montoyamoraga/cuadra/hardware/chufe-v-0-rev-a/chufe-v-0-rev-a.kicad_sch

## KiCad design hardware/chufe-v-0-rev-a/chufe-v-0-rev-a.kicad_sch (2026-10-26)

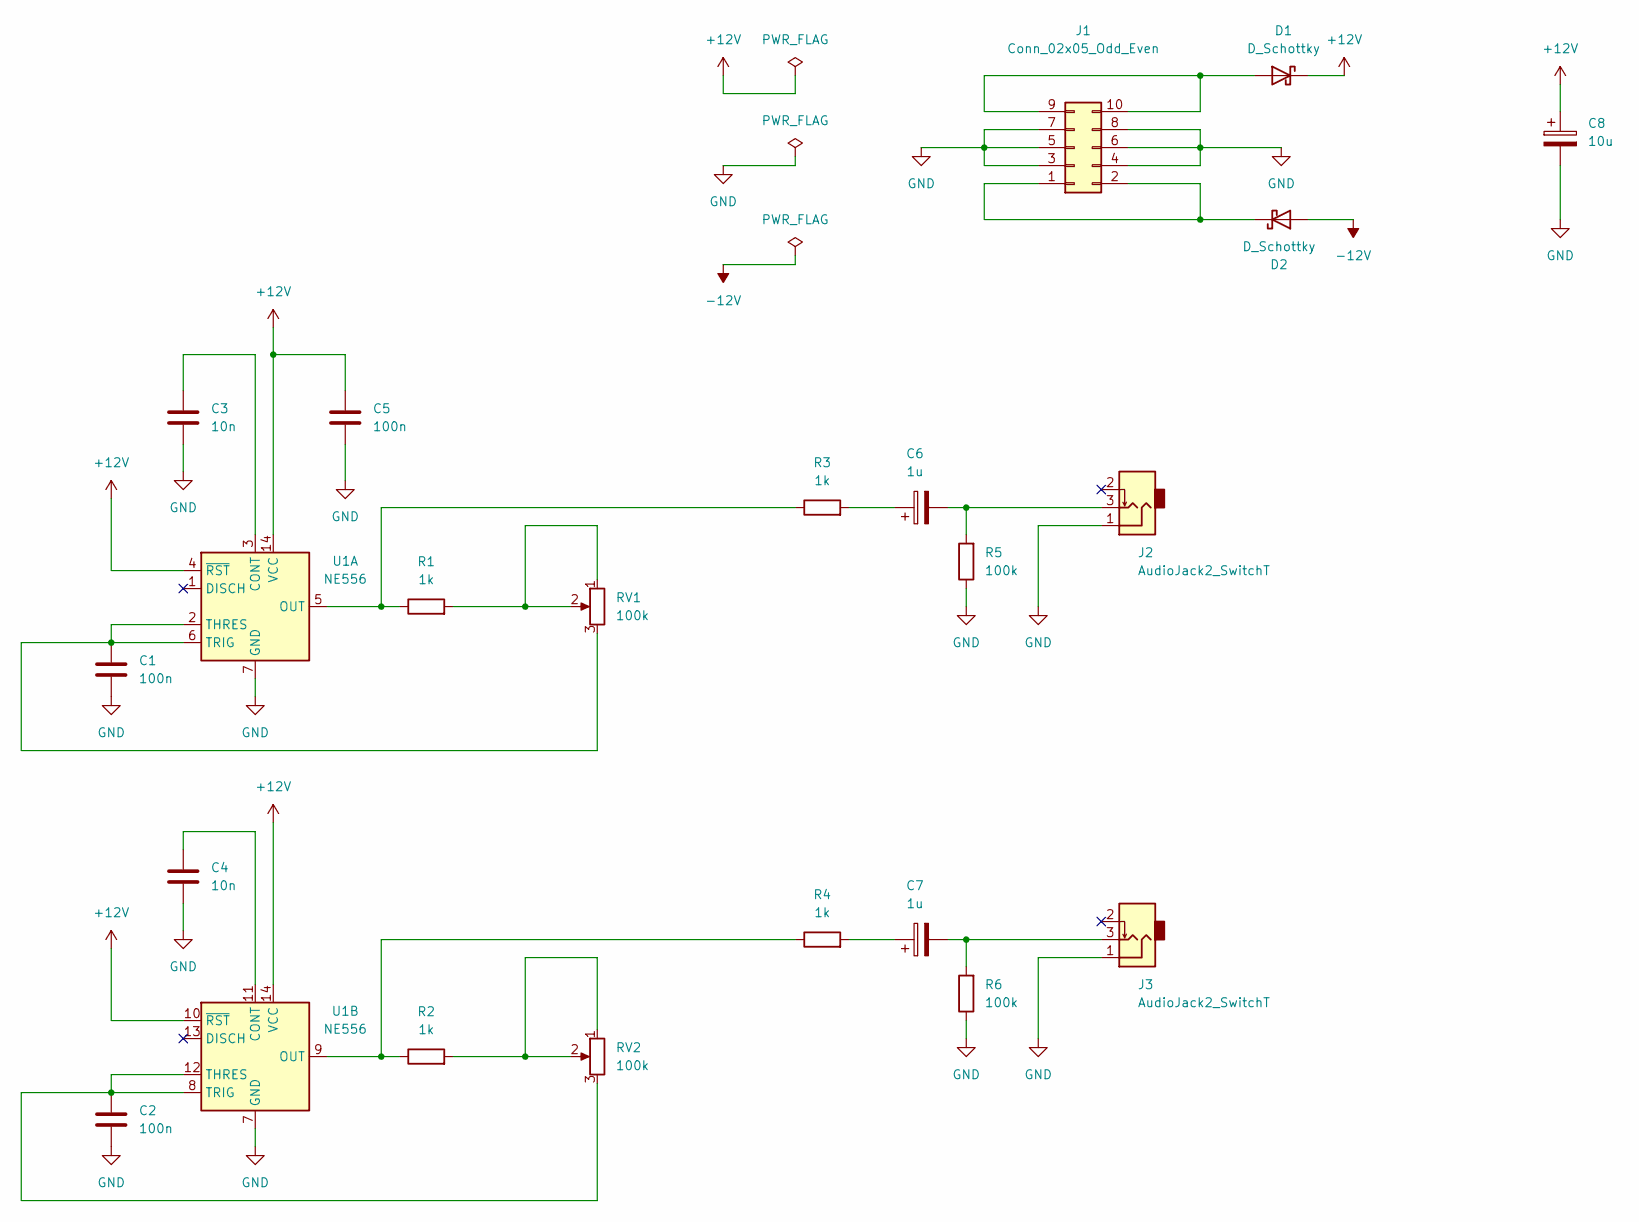
[picture p1: schematic chufe-v-0-rev-a.kicad_sch]

Parts:
C1, C2, C5: 100n
C3, C4: 10n
C6, C7: 1u
C8: 10u
D1, D2: D_Schottky
J1: Conn_02x05_Odd_Even
J2, J3: AudioJack2_SwitchT
R1, R2, R3, R4: 1k
R5, R6: 100k
RV1, RV2: 100k
U1: NE556

Connections:
+12V: C5.1, C8.1, D1.1 (K), U1.4 (~RST), U1.10 (~RST), U1.14 (VCC)
-12V: D2.2 (A)
GND: C1.2, C2.2, C3.2, C4.2, C5.2, C8.2, J1.3, J1.4, J1.5, J1.6, J1.7, J1.8, J2.1, J3.1, R5.1, R6.1, U1.7 (GND)
unnamed: C1.1, RV1.3, U1.2 (THRES), U1.6 (TRIG)
unnamed: C2.1, RV2.3, U1.8 (TRIG), U1.12 (THRES)
unnamed: C3.1, U1.3 (CONT)
unnamed: C4.1, U1.11 (CONT)
unnamed: C6.1, R3.2
unnamed: C6.2, J2.3, R5.2
unnamed: C7.1, R4.2
unnamed: C7.2, J3.3, R6.2
unnamed: D1.2 (A), J1.9, J1.10
unnamed: D2.1 (K), J1.1, J1.2
unnamed: R1.1, R3.1, U1.5 (OUT)
unnamed: R1.2, RV1.1, RV1.2
unnamed: R2.1, R4.1, U1.9 (OUT)
unnamed: R2.2, RV2.1, RV2.2
