montoyamoraga/cuadra/(commit log)

2026-10-25 agregar proyecto en blanco
    [chufe-v-0-rev-a.kicad_pcb, chufe-v-0-rev-a.kicad_sch]
2026-10-26 agregar borrador sch
    [chufe-v-0-rev-a.kicad_sch]
2026-10-26 agregar entrada FM y resistor THT para afinar
    [cuadra-v-0-rev-a.kicad_sch]
2026-11-11 agregar borrador
    [27ac9f2f9bbc492396fb63cfa35faaec.obj, 27ac9f2f9bbc492396fb63cfa35faaec.step, C169541.json, C25611.json, C2907232.json, C49678.json, C72485.json, C77083.json]
2026-11-11 agregar README, borrar cache
    [27ac9f2f9bbc492396fb63cfa35faaec.obj, 27ac9f2f9bbc492396fb63cfa35faaec.step, C169541.json, C25611.json, C2907232.json, C49678.json, C72485.json, C77083.json]
